laszlodaniel/CCDPCIBusTransceiver/PCB/V200/schematic/CCDPCIBusTransceiver_V200_schematic.pdf

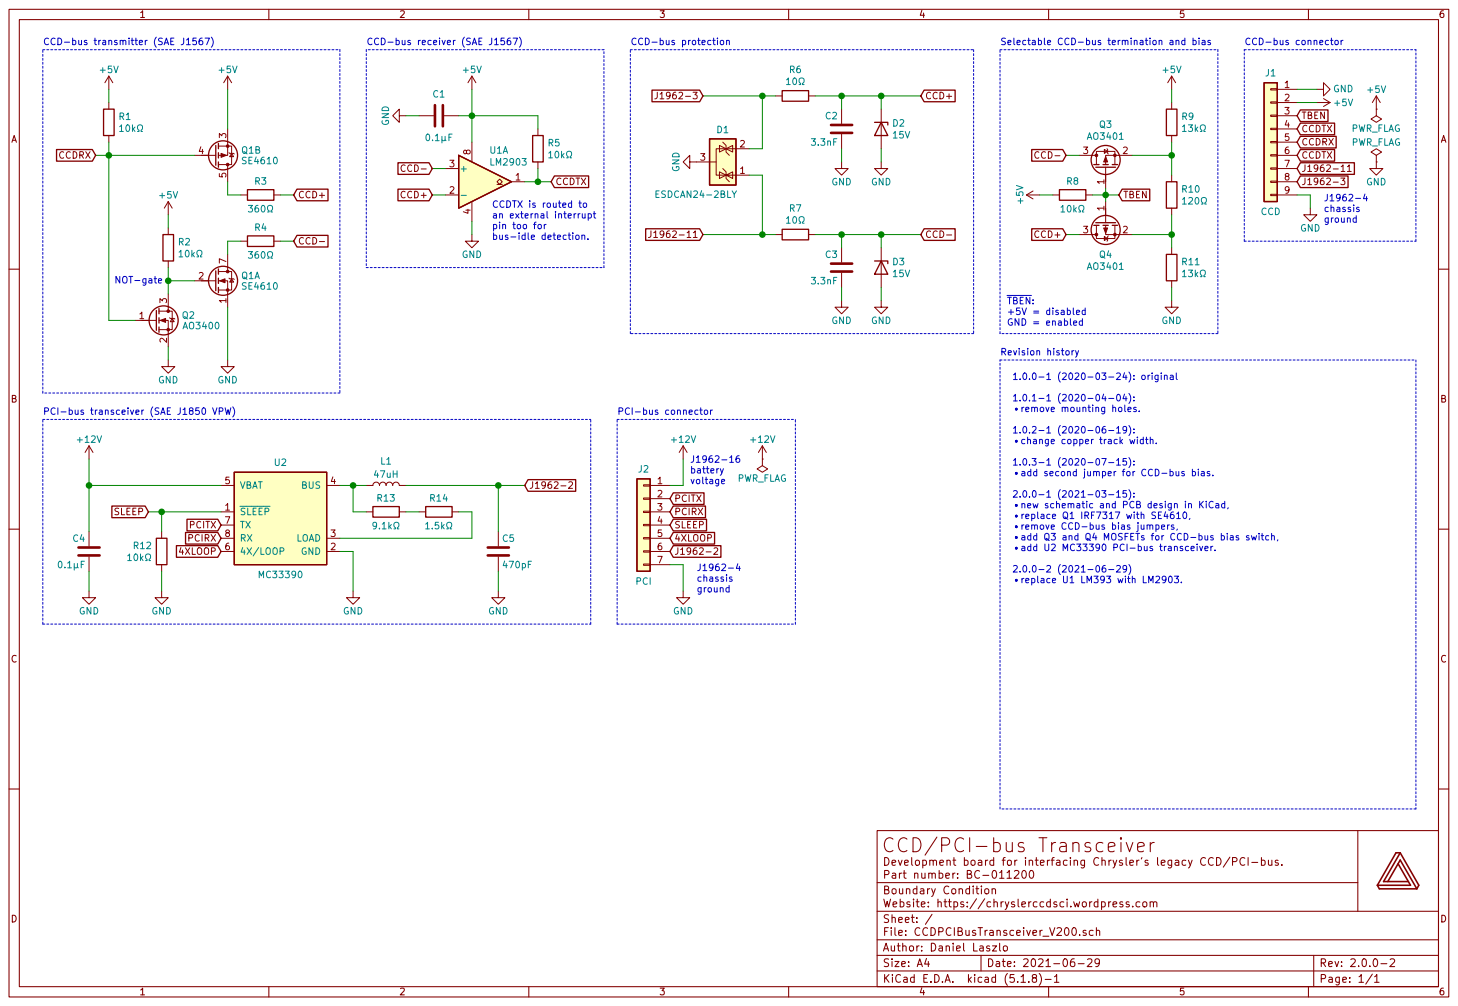
[picture p1: page 1]

CCD-bus receiver (SAE J1567)

PCI-bus transceiver (SAE J1850 VPW)

change copper track width.

add second jumper for CCD-bus bias.

new schematic and PCB design in KiCad,
replace Q1 IRF7317 with SE4610,
remove CCD-bus bias jumpers, add Q3 and Q4 MOSFETs for CCD-bus bias switch, add U2 MC33390 PCI-bus transceiver. 2.0.0-2 (2021-06-29)

CCD/PCI-bus Transceiver
Part number: BC-011200 Development board for interfacing Chrysler's legacy CCD/PCI-bus.

File: CCDPCIBusTransceiver_V200.sch Sheet: / Boundary Condition Author: Daniel Laszlo Website: https://chryslerccdsci.wordpress.com
