laszlodaniel/CCDPCIBusTransceiver/(commit log)

2021-03-18 PCI-bus RX/TX-pin labels on the PCB are accidentally reversed
    MC33390 has its pins named backwards.
2021-06-05 Update PCI2CCD_translator.ino
    Converted CCD-bus messages are displayed in the Arduino Serial Monitor.
2021-06-29 Update schematic
2023-02-09 Add V300 schematics
2025-10-23 Add V310 schematics
